dirkandterra/MotorWithAS5600/CAD/as6500 mount.FCStd

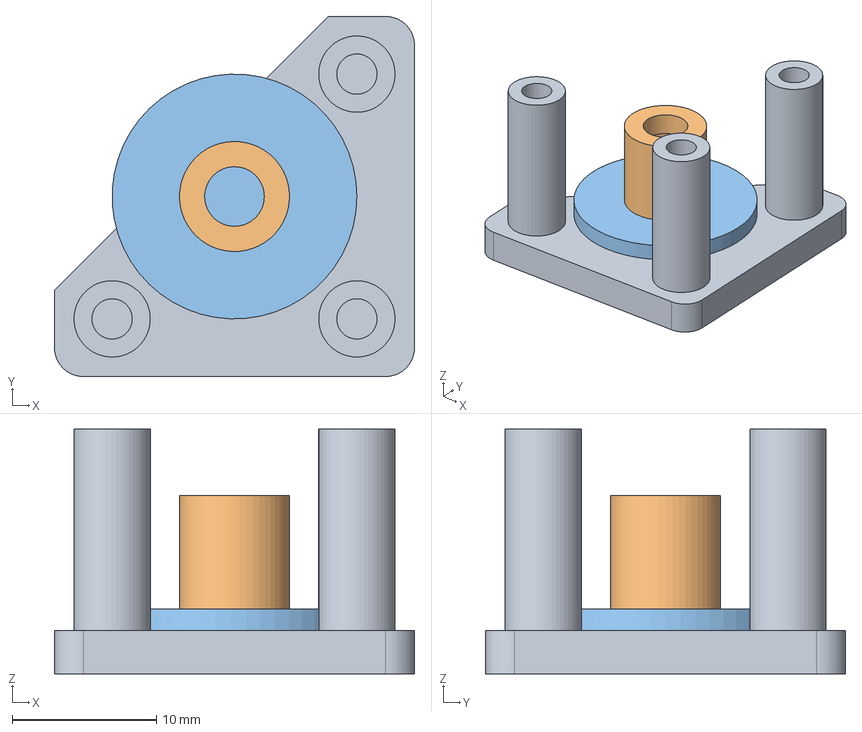
[picture p1: CAD file, 2026-09-03]
CAD/as6500 mount.FCStd
25.0 x 25.0 x 17.0 mm
