dirkandterra/MotorWithAS5600/CAD/as6500 mount2.FCStd

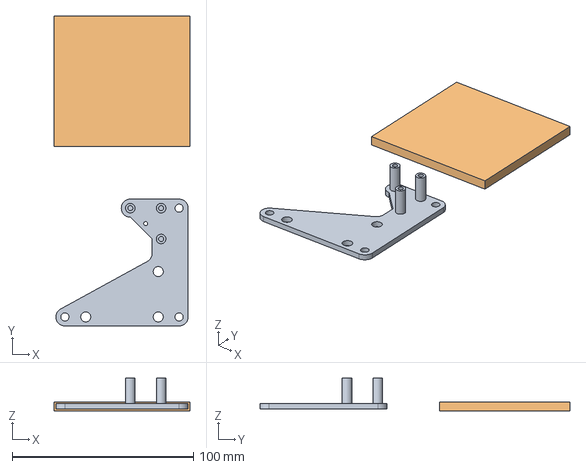
[picture p2: CAD file, 2026-09-03]
CAD/as6500 mount2.FCStd
75.0 x 171.0 x 18.0 mm
MainBase
Stock
