dirkandterra/MotorWithAS5600/ESP32_C3_MotorDriver-V2/CAMOutputs/Assembly/ESP32_C3_MotorDriver.txt

Partlist exported from C:/Users/dirkr/OneDrive/Documents/EAGLE/projects/ESP32_C3_MotorDriver/ESP32_C3_MotorDriver.sch at 9/12/2026 12:25 PM

Qty Value                             Device                            Package                        Parts    Description                             POPULARITY
2                                     C-USC0805                         C0805                          C1, C2   CAPACITOR, American symbol                        
2                                     PINHD-1X2                         1X02                           JP1, JP4 PIN HEADER                              98        
2                                     PINHD-1X4                         1X04                           JP2, JP3 PIN HEADER                              91        
1   120                               R-US_M0805                        M0805                          R3       RESISTOR, American symbol                         
1   330                               R-US_M0805                        M0805                          R4       RESISTOR, American symbol                         
2   4.7k                              R-US_M0805                        M0805                          R1, R2   RESISTOR, American symbol                         
1   7805                              7805                              TO252-3                        U4                                                         
1   BARREL_JACK_3PINPJ-102A_2MM_HOLES BARREL_JACK_3PINPJ-102A_2MM_HOLES PJ-102A_2MM_HOLES              CON1                                                       
1   BAT60J                            BAT60J                            SOD323_ST                      D1       Schottky barrier diode                  7         
1   ESP32C3ZERO                       ESP32C3ZERO                       ESP32SUPERMINI_ESP32-SUPERMINI U1                                                         
1   L293DDIP16                        L293DDIP16                        DIP16_7.62MM                   U3       Motor Driver, Quadruple Half-H, 4.5-36V           
1   LED_SMD_SM                        LED_SMD_SM                        LED_SMD_SM                     LED1                                                       
1   SN65HVD232DSOIC8                  SN65HVD232DSOIC8                  SOIC-8                         U2
