dirkandterra/MotorWithAS5600/ESP32_C3_MotorDriver-V2/CAMOutputs/Assembly/PnP_ESP32_C3_MotorDriver_front.txt

D1	56.00	16.50	270.00	BAT60J	SOD323_ST
LED1	48.60	24.60	0.00	LED_SMD_SM	LED_SMD_SM
R4	49.00	27.00	0.00	330	M0805
