dirkandterra/MotorWithAS5600/ESP32_C3_MotorDriver-V2/CAMOutputs/Assembly/PnP_ESP32_C3_MotorDriver_back.txt

C1	22.76	13.53	0.00		C0805
C2	27.32	3.47	180.00		C0805
R1	38.00	38.00	180.00	4.7k	M0805
R2	37.88	41.06	180.00	4.7k	M0805
R3	55.86	26.10	270.00	120	M0805
U2	50.68	25.89	180.00	SN65HVD232DSOIC8	SOIC-8
U4	23.59	8.07	270.00	7805	TO252-3
