dirkandterra/MotorWithAS5600/ESP32_C3_MotorDriver-V2/ESP32_C3_MotorDriver_brd.pdf

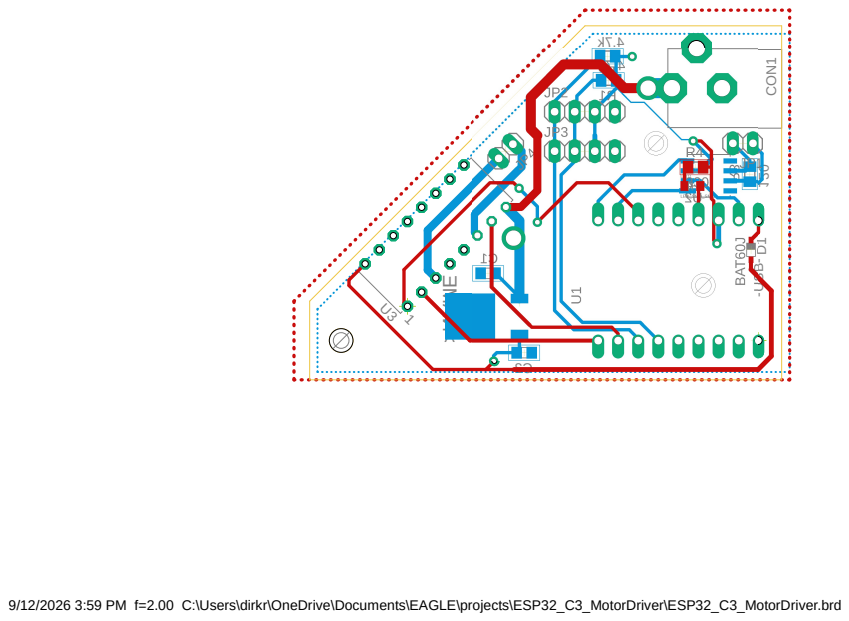
[picture p3: page 1]

9/12/2026 3:59 PM f=2.00 C:\Users\dirkr\OneDrive\Documents\EAGLE\projects\ESP32_C3_MotorDriver\ESP32_C3_MotorDriver.brd
