dirkandterra/MotorWithAS5600/ESP32_C3_MotorDriver-V2/ESP32_Zero_MotorDriver.pdf

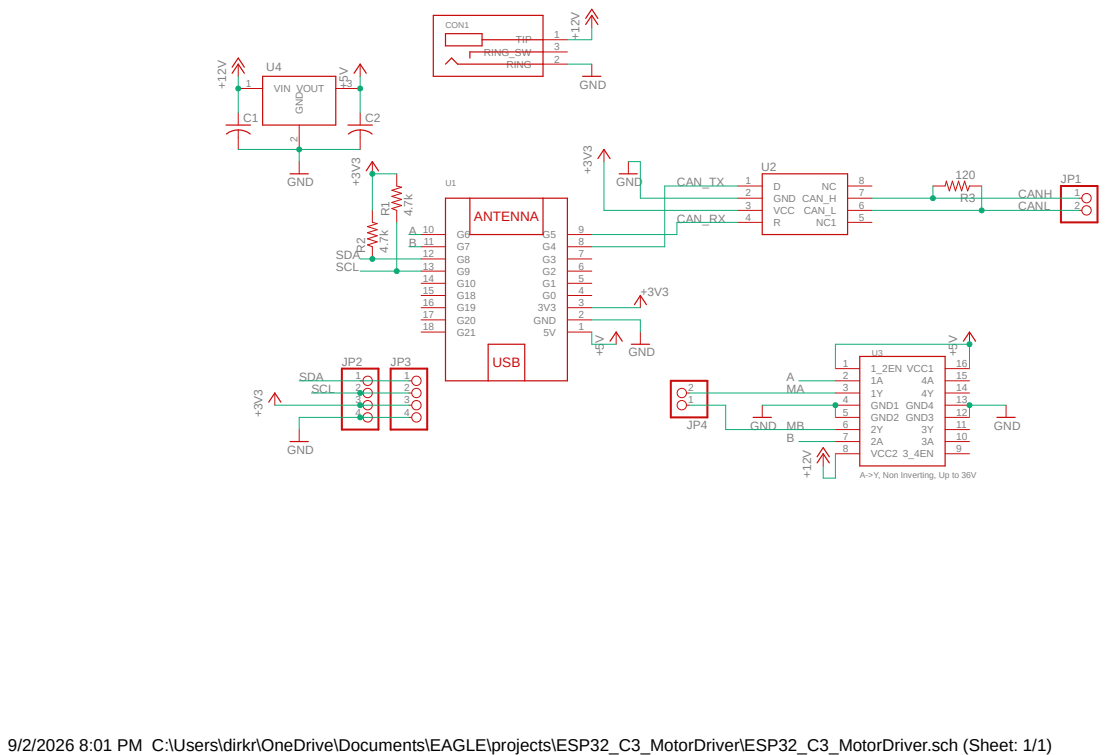
[picture p4: page 1]

A->Y, Non Inverting, Up to 36V ⁴.7k
SDA
SCL

9/2/2026 8:01 PM C:\Users\dirkr\OneDrive\Documents\EAGLE\projects\ESP32_C3_MotorDriver\ESP32_C3_MotorDriver.sch (Sheet: 1/1)

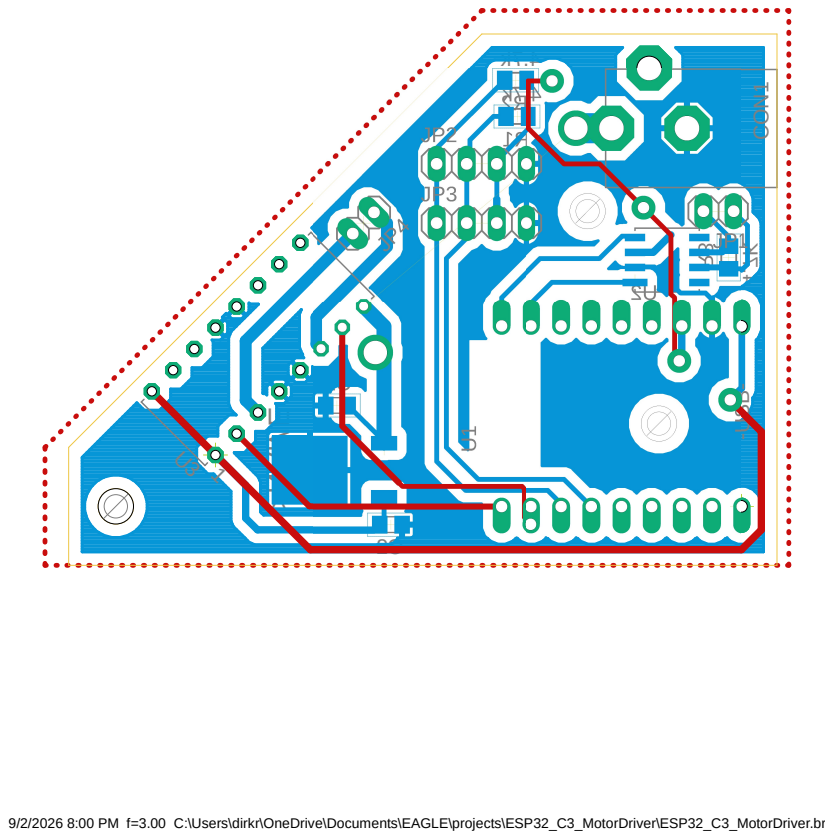
[picture p5: page 2]

9/2/2026 8:00 PM f=3.00 C:\Users\dirkr\OneDrive\Documents\EAGLE\projects\ESP32_C3_MotorDriver\ESP32_C3_MotorDriver.brd
