dirkandterra/MotorWithAS5600/ESP32_C3_MotorDriver-V2/CAM/_OUTBOT.pdf

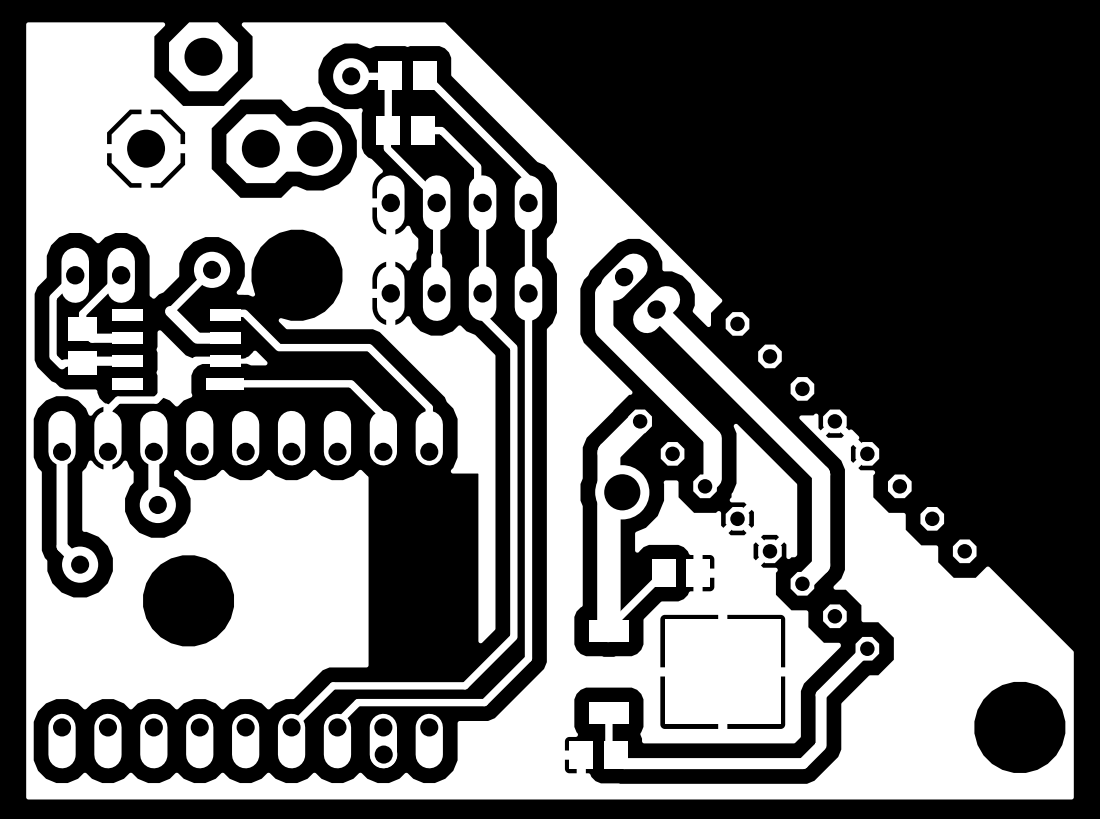
[picture p6: page 1]
