dirkandterra/MotorWithAS5600/ESP32_C3_MotorDriver-V2/CAM/_OUTTOP.pdf

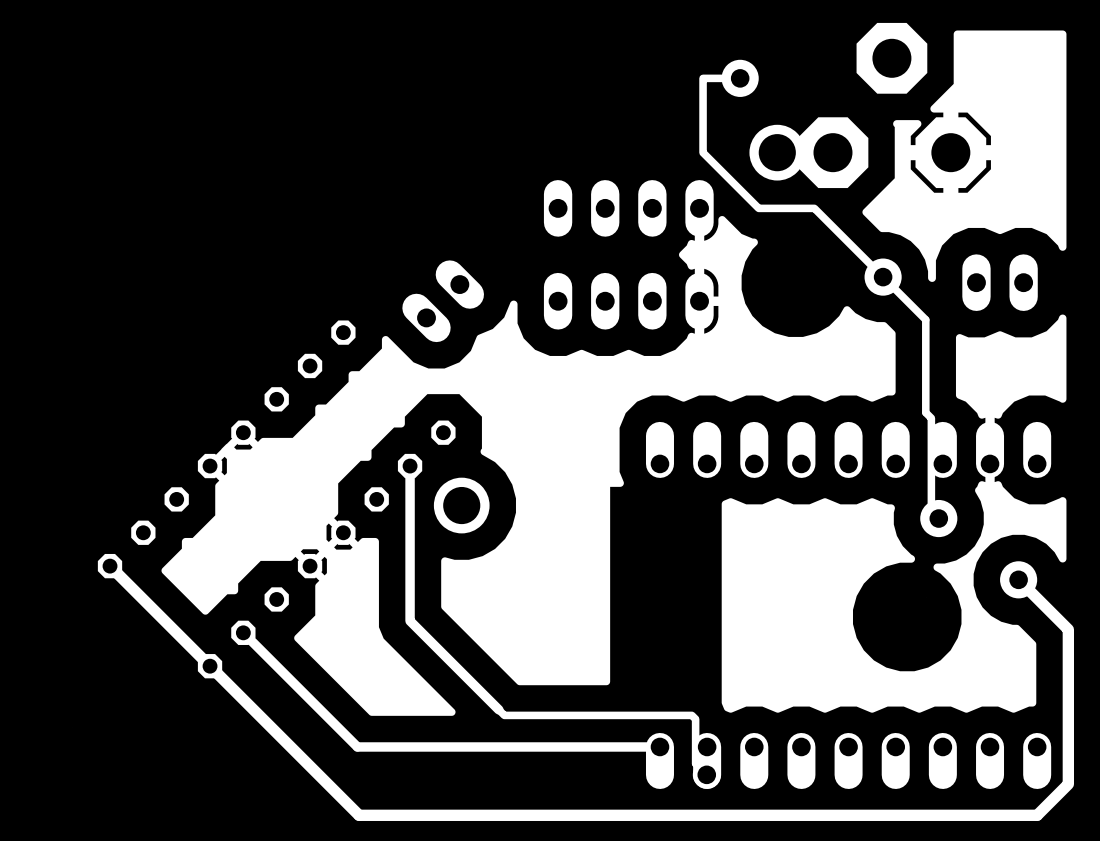
[picture p7: page 1]
