dirkandterra/MotorWithAS5600/ESP32_C3_MotorDriver-V2/CAM/bout.pdf

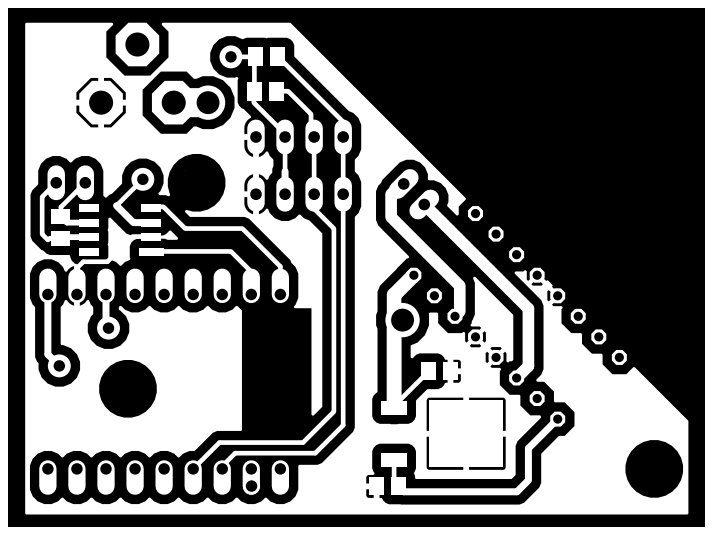
[picture p8: page 1]
