dirkandterra/MotorWithAS5600/ESP32_C3_MotorDriver-V2/CAM/EagleOverlord.pdf

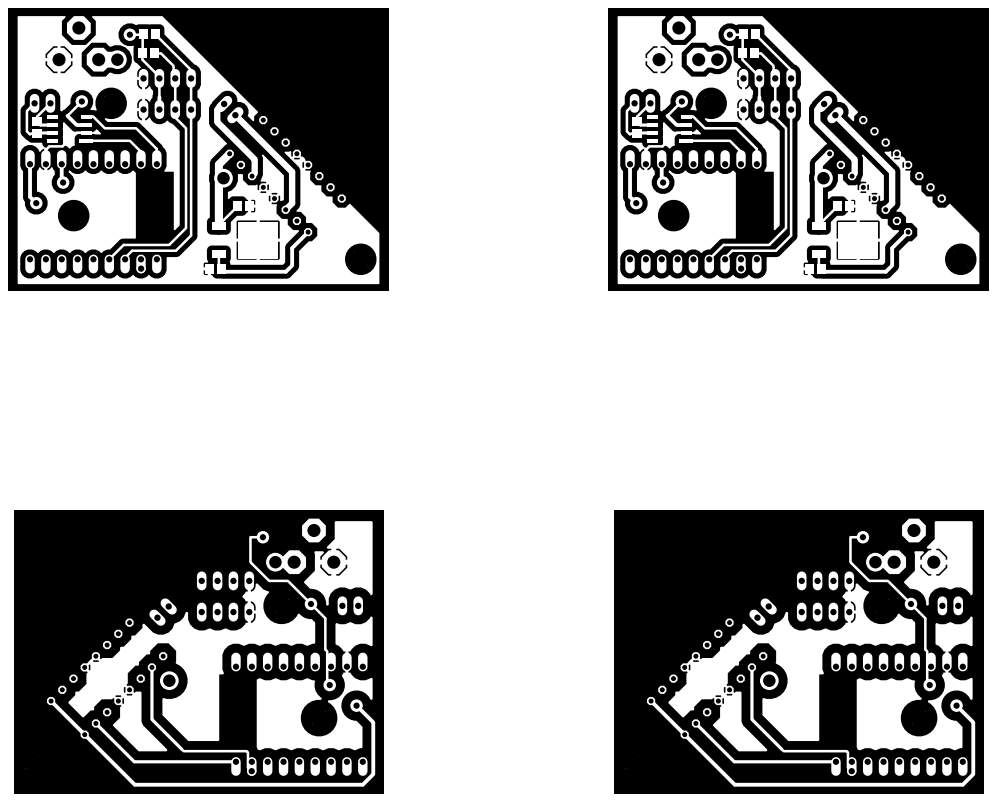
[picture p9: page 1]
