dirkandterra/MotorWithAS5600/ESP32_C3_MotorDriver-V2/CAM/tout.pdf

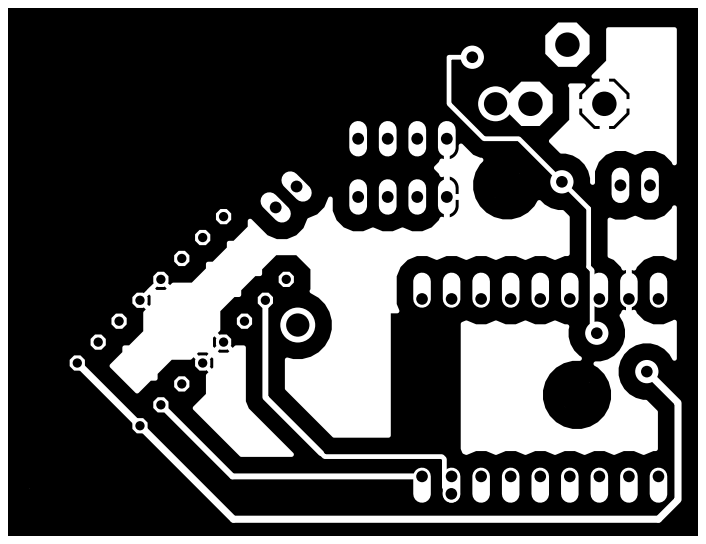
[picture p10: page 1]
