dirkandterra/MotorWithAS5600/ESP32_C3_MotorDriver-V2/ESP32_C3_MotorDriver.brd

## EAGLE design ESP32_C3_MotorDriver-V2/ESP32_C3_MotorDriver.brd (2026-09-12)

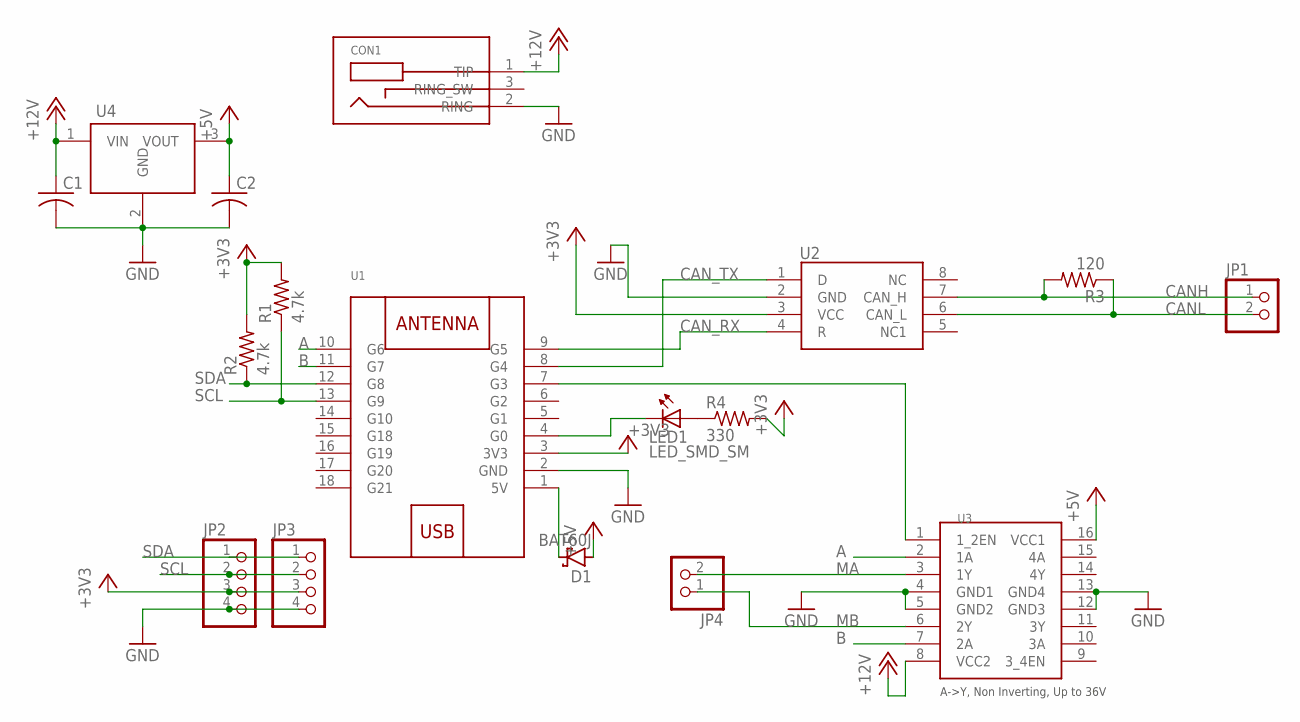
[picture p11: schematic ESP32_C3_MotorDriver.sch]

Parts:
C1, C2: C-USC0805; C0805
CON1: BARREL_JACK_3PINPJ-102A_2MM_HOLES; PJ-102A_2MM_HOLES
D1: BAT60J; SOD323_ST
JP1, JP4: PINHD-1X2; 1X02
JP2, JP3: PINHD-1X4; 1X04
LED1: LED_SMD_SM
R1, R2: 4.7k; M0805
R3: 120; M0805
R4: 330; M0805
U1: ESP32C3ZERO; ESP32SUPERMINI_ESP32-SUPERMINI
U2: SN65HVD232DSOIC8; SOIC-8
U3: L293DDIP16; DIP16_7.62MM
U4: 7805; TO252-3

Connections:
+3V3: JP2.3, JP3.3, R1.2, R2.2, R4.2, U1.3 (3V3), U2.3 (VCC)
+5V: C2.1, D1.A, U3.16 (VCC1), U4.3 (VOUT)
+12V: C1.1, CON1.1 (TIP), U3.8 (VCC2), U4.1 (VIN)
A: U1.10 (G6), U3.2 (1A)
B: U1.11 (G7), U3.7 (2A)
CANH: JP1.1, R3.2, U2.7 (CAN_H)
CANL: JP1.2, R3.1, U2.6 (CAN_L)
CAN_RX: U1.9 (G5), U2.4 (R)
CAN_TX: U1.8 (G4), U2.1 (D)
G19: U1.16 (G19)
GND: C1.2, C2.2, CON1.2 (RING), JP2.4, JP3.4, U1.2 (GND), U2.2 (GND), U3.4 (GND1), U3.5 (GND2), U3.12 (GND3), U3.13 (GND4), U4.2 (GND)
MA: JP4.2, U3.3 (1Y)
MB: JP4.1, U3.6 (2Y)
unnamed: U1.7 (G3), U3.1 (1_2EN)
unnamed: D1.C, U1.1 (5V)
unnamed: LED1.1 (A), R4.1
unnamed: LED1.2 (C), U1.4 (G0)
SCL: JP2.2, JP3.2, R1.1, U1.13 (G9)
SDA: JP2.1, JP3.1, R2.1, U1.12 (G8)

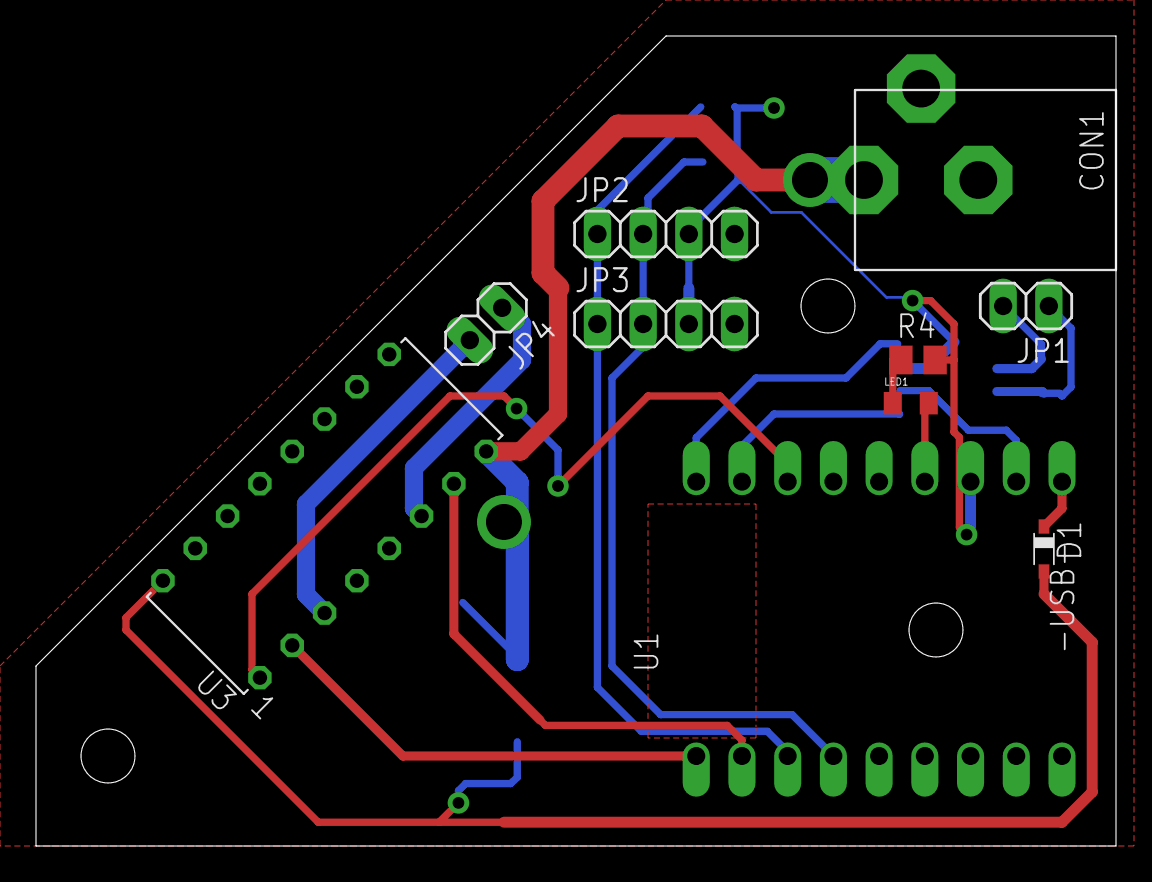
[picture p12: board ESP32_C3_MotorDriver.brd from above]

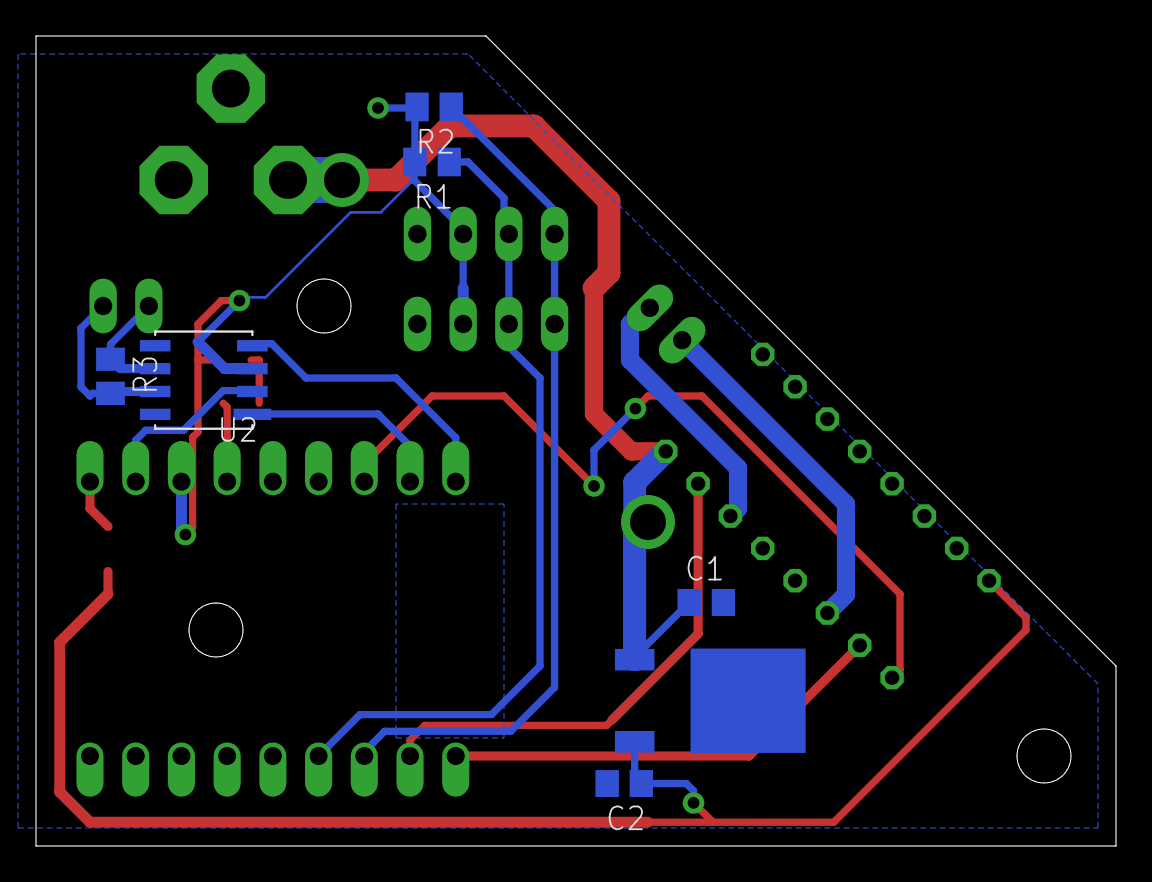
[picture p13: board ESP32_C3_MotorDriver.brd from below]

Board: 2 copper layers, 60.0 x 45.0 mm, 17 parts (7 on the bottom side), 18 nets.
