dirkandterra/MotorWithAS5600/(commit log)

2026-09-03 Added board and CAD files
    [ESP32_C3_MotorDriver.brd, ESP32_C3_MotorDriver.sch, as6500 mount.FCStd, as6500 mount2.FCStd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]
2026-09-12 Got CAN working and error trapped no I2C
    [ESP32_C3_MotorDriver.brd, ESP32_C3_MotorDriver.sch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]
